robitibillo/Datalogger_lowcost_ATmega/fotos/Diagrama de flujo final.png

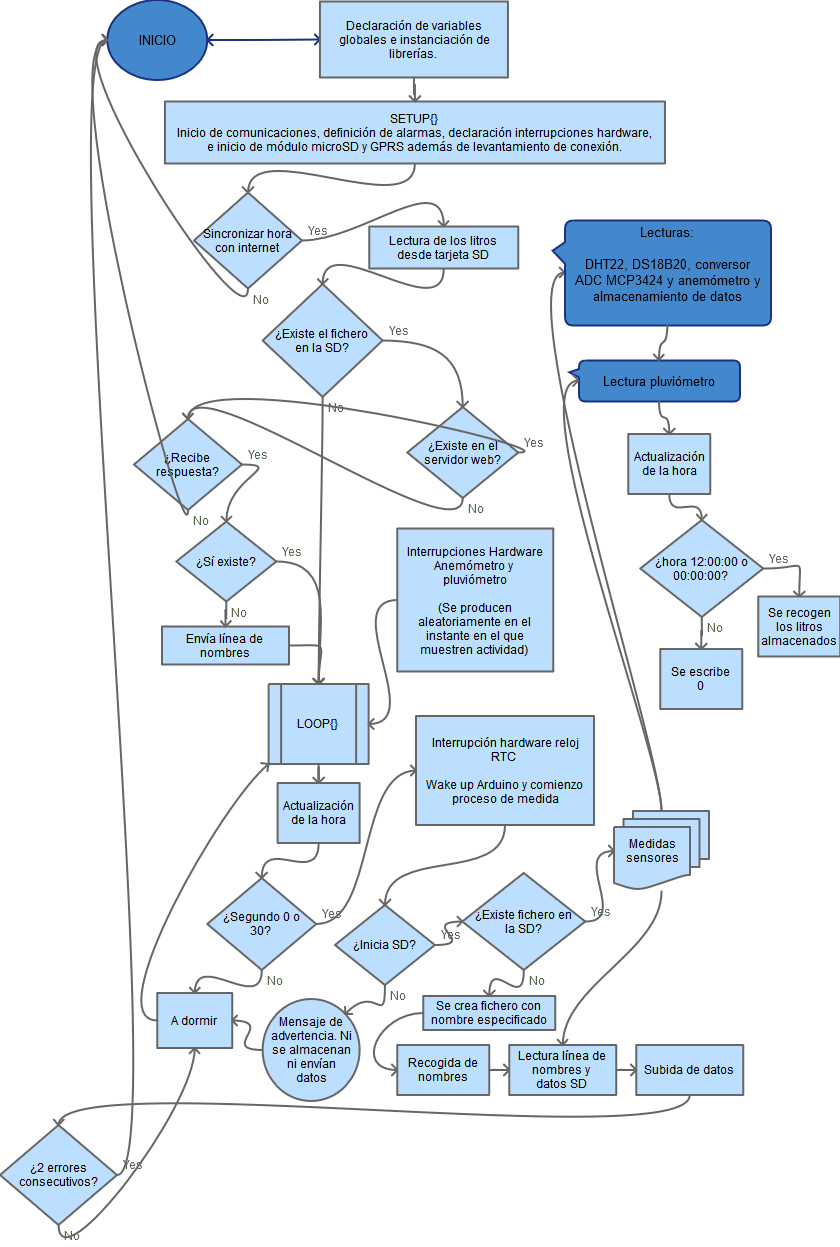
fotos/Diagrama de flujo final.png
