robitibillo/Datalogger_lowcost_ATmega/fotos/Software PHP recogida datos.png

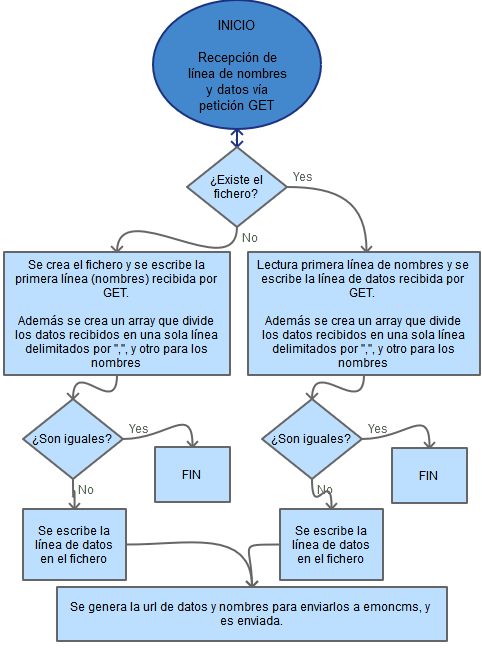
fotos/Software PHP recogida datos.png
