robitibillo/Datalogger_lowcost_ATmega/fotos/TFG_fritzing.png

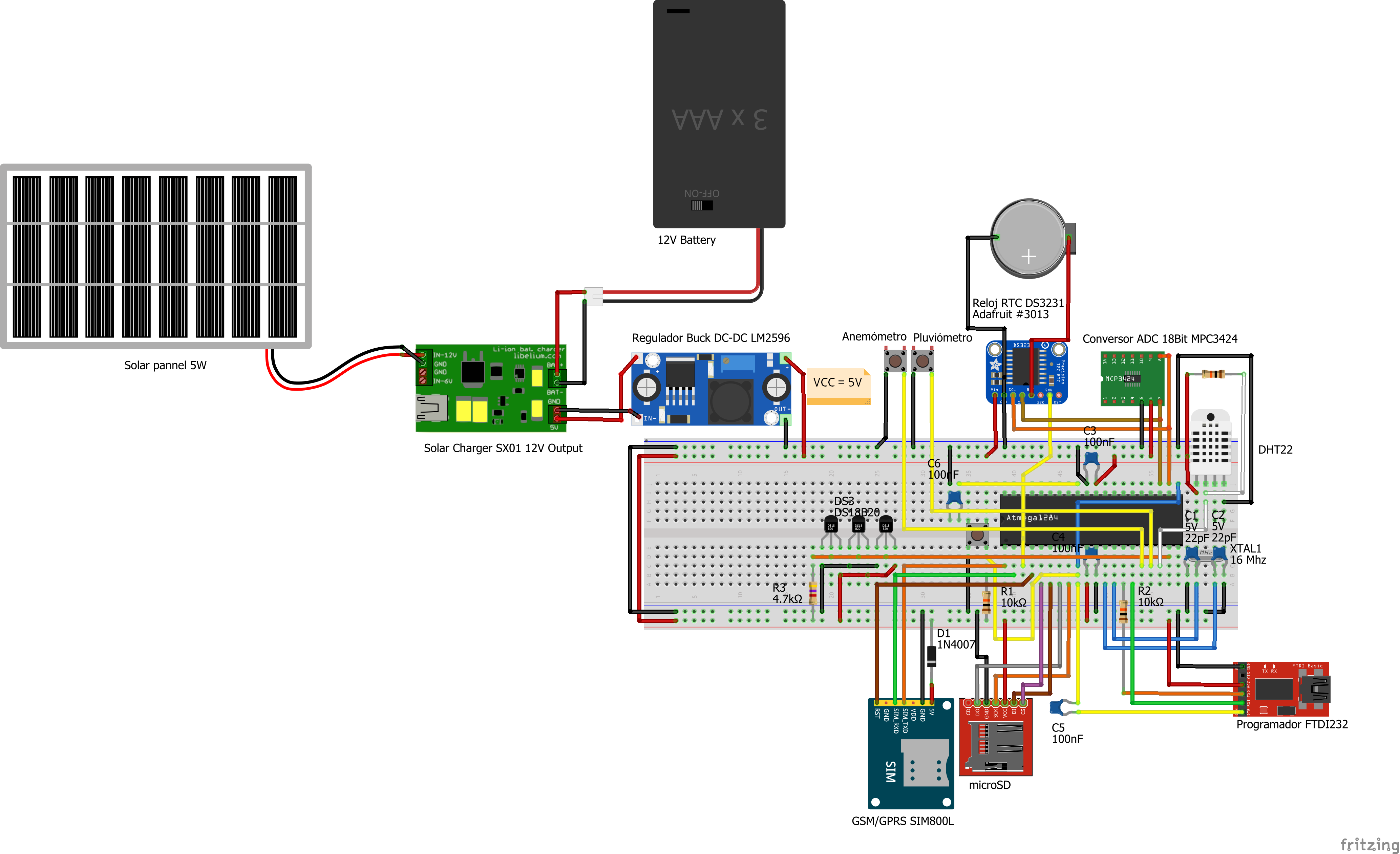
fotos/TFG_fritzing.png
