robitibillo/Datalogger_lowcost_ATmega/fotos/TFG_fritzing_medida_corriente.png

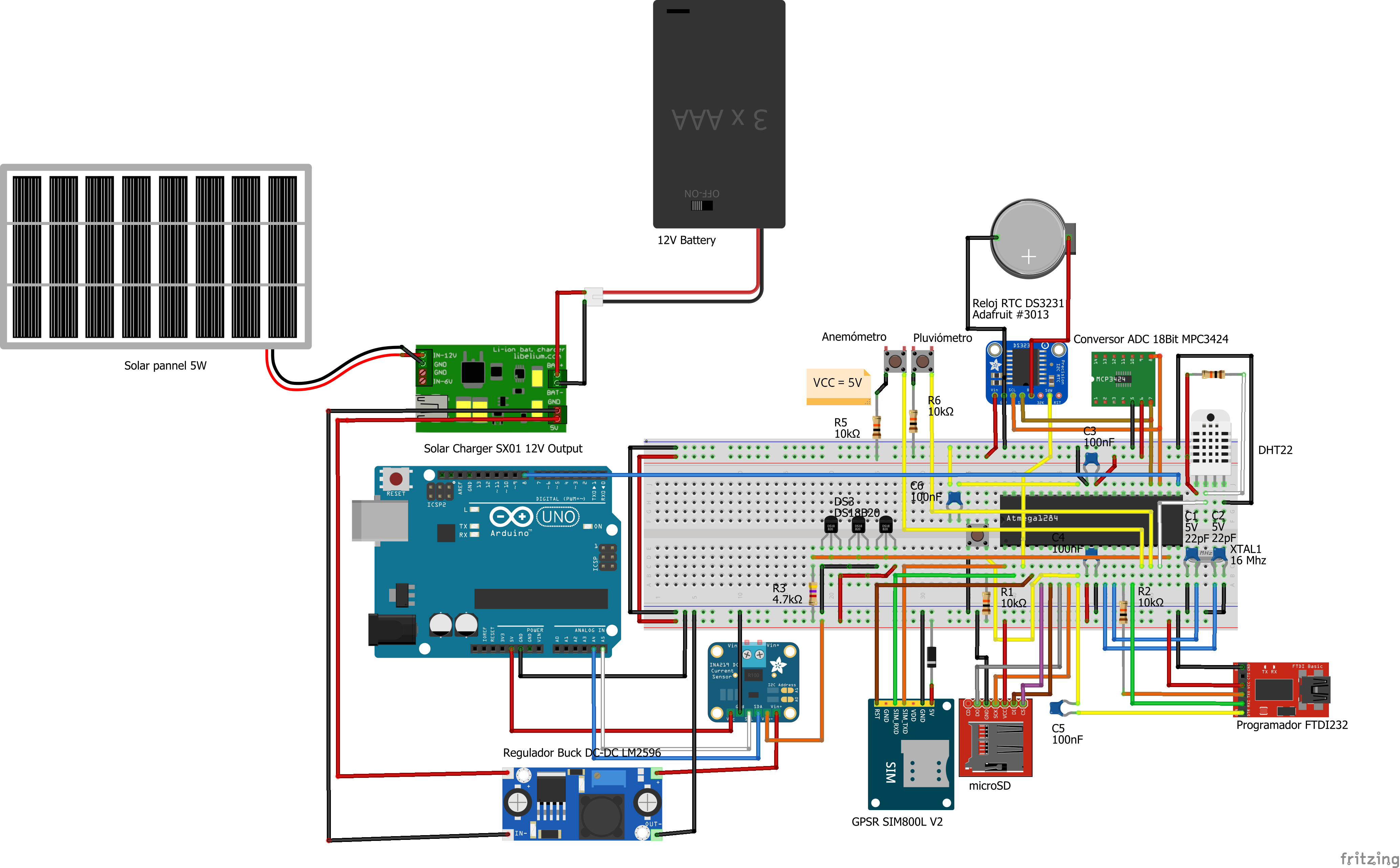
fotos/TFG_fritzing_medida_corriente.png
